BenKohn2004/Reel_Camera_Tracker/Encoder Ring.pdf

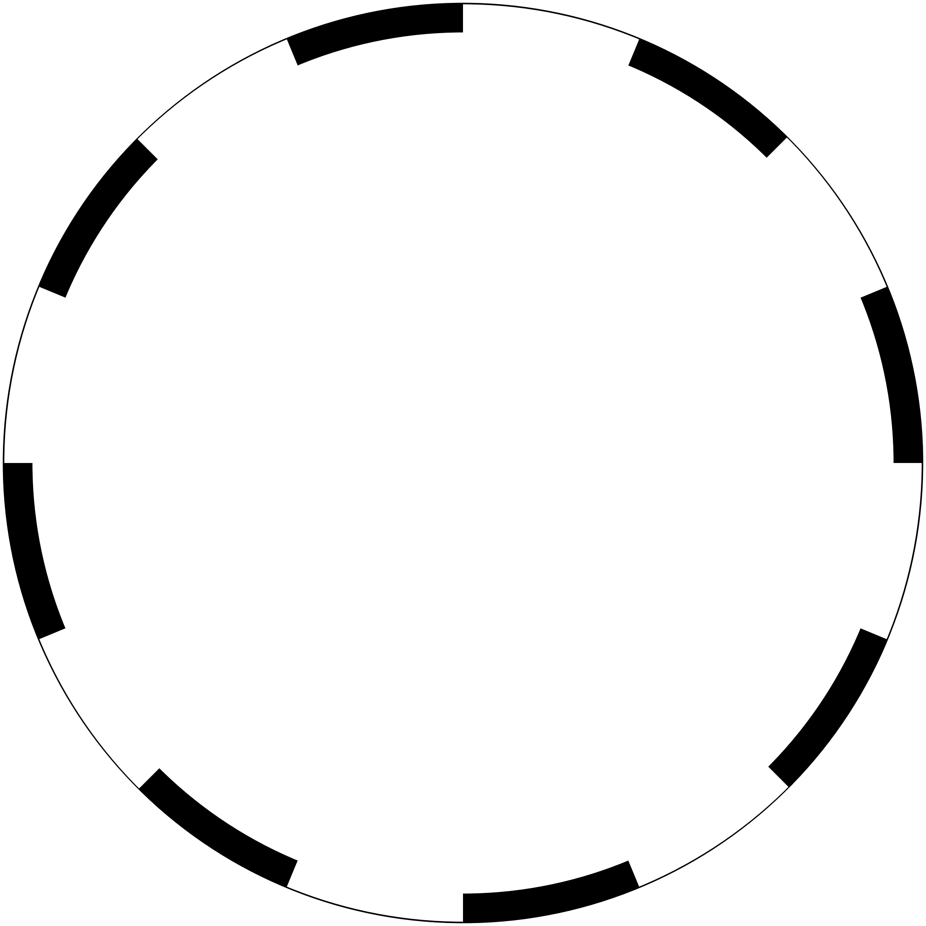
[picture p6: figure]
