BenKohn2004/Reel_Camera_Tracker/(commit log)

2025-04-30 Add files via upload
    Tiled Encoder Reel for printing on:
    8.5" x 11" Full Sheet Label Sticker Paper for Laser & Inkjet Printers [100 Sheets,100 Labels]
2025-04-30 Rename Favero Reel Encoder Tiled Rev 1.pdf to Favero Reel Encoder Tiled.pdf
2026-06-30 Add files via upload
    Encoder Ring
